quezadaminter/GrblJogCtrlSchematic/ButtonMatrix.sch

## KiCad design ButtonMatrix.sch (2022-01-11)

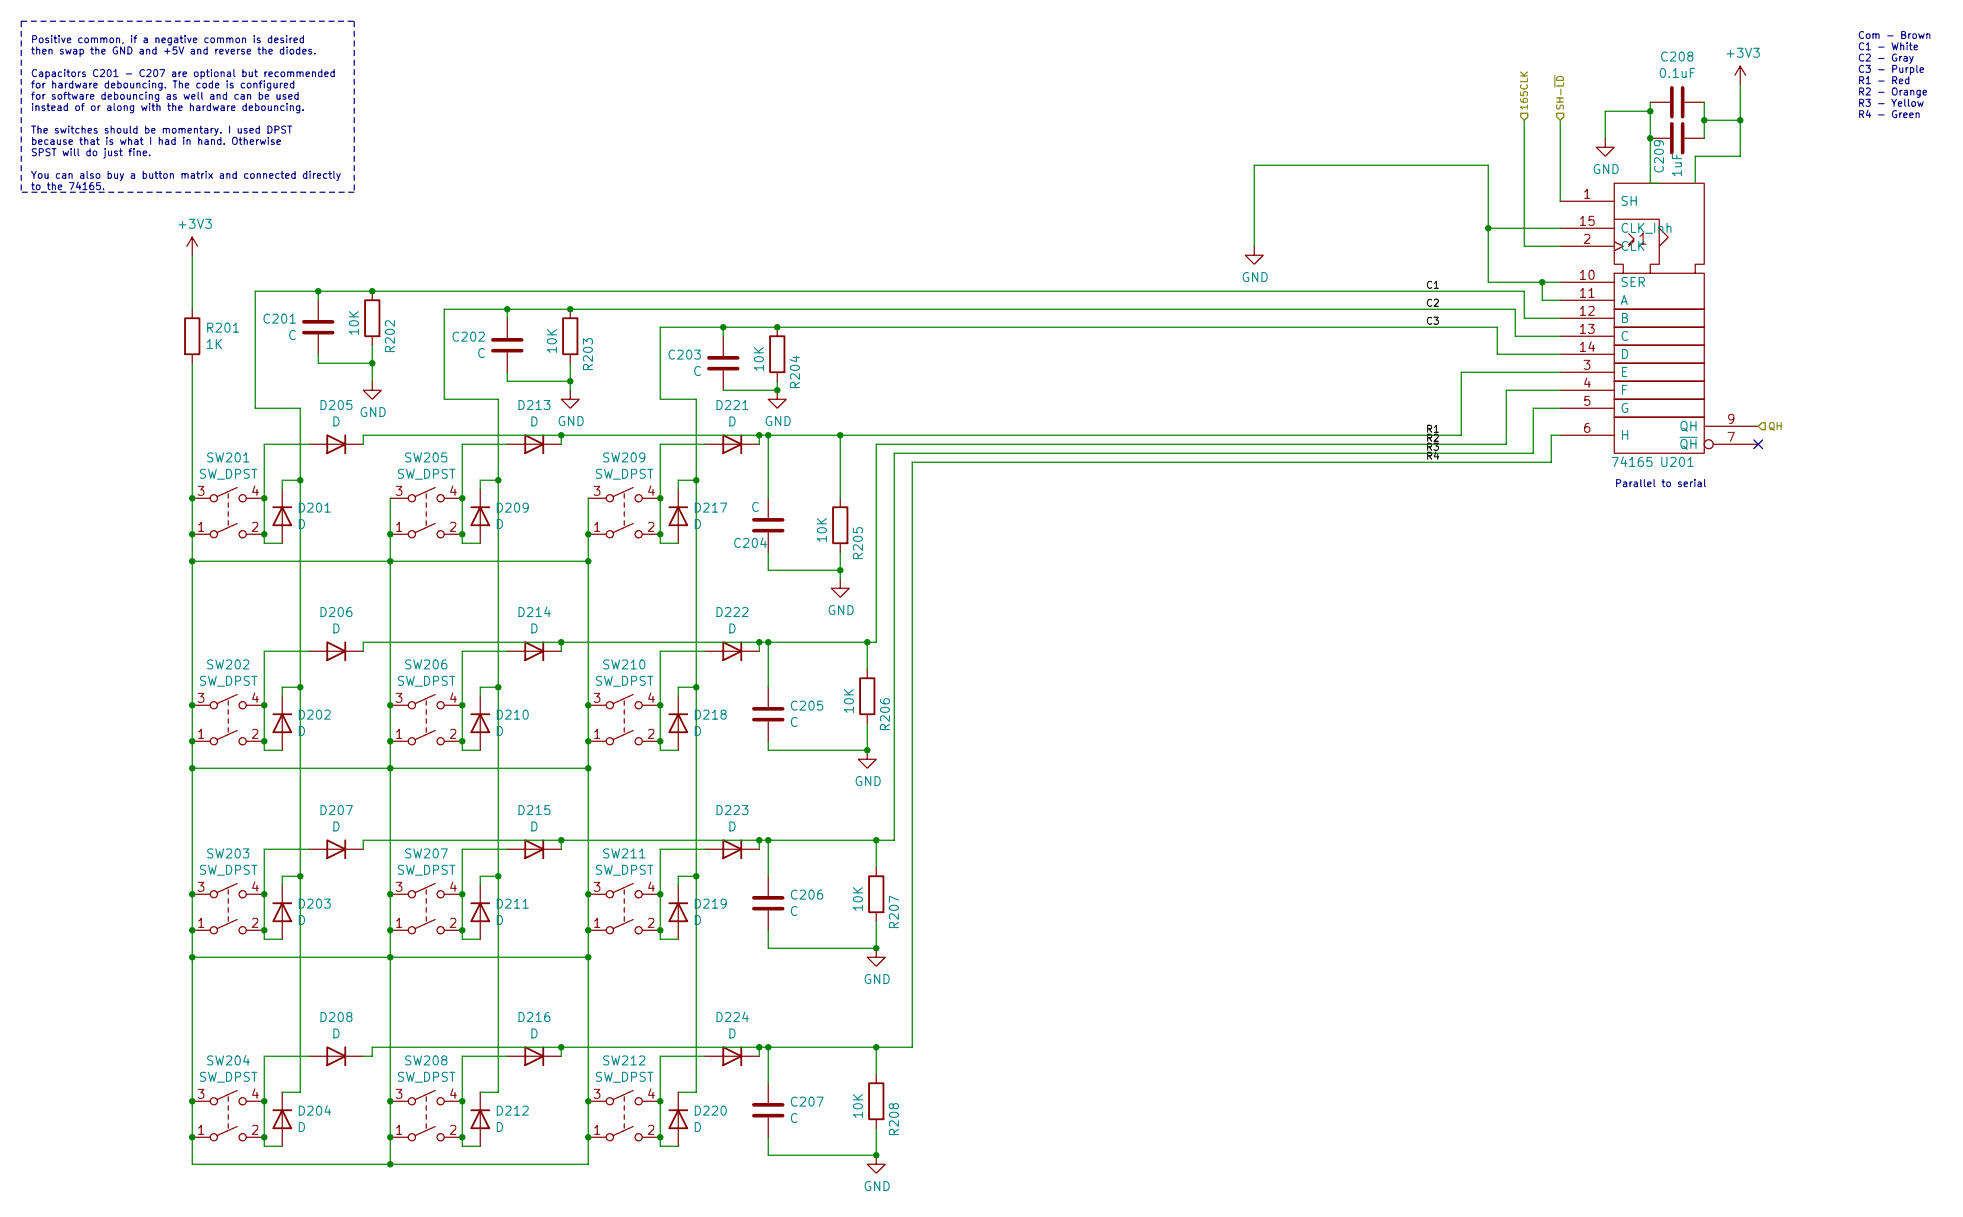
[picture p1: schematic ButtonMatrix.sch]

Parts:
C201, C202, C203, C204, C205, C206, C207: C
C208: 0.1uF
C209: 1uF
D201, D202, D203, D204, D205, D206, D207, D208, D209, D210, D211, D212, D213, D214, D215, D216, D217, D218, D219, D220, D221, D222, D223, D224: D
R201: 1K
R202, R203, R204, R205, R206, R207, R208: 10K
SW201, SW202, SW203, SW204, SW205, SW206, SW207, SW208, SW209, SW210, SW211, SW212: SW_DPST
U201: 74165

Connections:
165CLK: U201.2 (CLK)
+3V3: C208.1, C209.1, R201.1, U201.16 (VCC)
C1: C201.2, D201.1 (K), D202.1 (K), D203.1 (K), D204.1 (K), R202.1, U201.12 (B)
C2: C202.2, D209.1 (K), D210.1 (K), D211.1 (K), D212.1 (K), R203.1, U201.13 (C)
C3: C203.2, D217.1 (K), D218.1 (K), D219.1 (K), D220.1 (K), R204.1, U201.14 (D)
GND: C201.1, C202.1, C203.1, C204.2, C205.2, C206.2, C207.2, C208.2, C209.2, R202.2, R203.2, R204.2, R205.2, R206.2, R207.2, R208.2, U201.8 (GND), U201.10 (SER), U201.11 (A), U201.15 (CLK_Inh)
unnamed: D201.2 (A), D205.2 (A), SW201.2, SW201.4
unnamed: D202.2 (A), D206.2 (A), SW202.2, SW202.4
unnamed: D203.2 (A), D207.2 (A), SW203.2, SW203.4
unnamed: D204.2 (A), D208.2 (A), SW204.2, SW204.4
unnamed: D209.2 (A), D213.2 (A), SW205.2, SW205.4
unnamed: D210.2 (A), D214.2 (A), SW206.2, SW206.4
unnamed: D211.2 (A), D215.2 (A), SW207.2, SW207.4
unnamed: D212.2 (A), D216.2 (A), SW208.2, SW208.4
unnamed: D217.2 (A), D221.2 (A), SW209.2, SW209.4
unnamed: D218.2 (A), D222.2 (A), SW210.2, SW210.4
unnamed: D219.2 (A), D223.2 (A), SW211.2, SW211.4
unnamed: D220.2 (A), D224.2 (A), SW212.2, SW212.4
unnamed: R201.2, SW201.1, SW201.3, SW202.1, SW202.3, SW203.1, SW203.3, SW204.1, SW204.3, SW205.1, SW205.3, SW206.1, SW206.3, SW207.1, SW207.3, SW208.1, SW208.3, SW209.1, SW209.3, SW210.1, SW210.3, SW211.1, SW211.3, SW212.1, SW212.3
QH: U201.9 (QH)
R1: C204.1, D205.1 (K), D213.1 (K), D221.1 (K), R205.1, U201.3 (E)
R2: C205.1, D206.1 (K), D214.1 (K), D222.1 (K), R206.1, U201.4 (F)
R3: C206.1, D207.1 (K), D215.1 (K), D223.1 (K), R207.1, U201.5 (G)
R4: C207.1, D208.1 (K), D216.1 (K), D224.1 (K), R208.1, U201.6 (H)
SH-~LD: U201.1 (SH)

Notes on the sheet:
Com - Brown C1 - White C2 - Gray C3 - Purple R1 - Red R2 - Orange R3 - Yellow R4 - Green
Parallel to serial
Positive common, if a negative common is desired then swap the GND and +5V and reverse the diodes. Capacitors C201 - C207 are optional but recommended for hardware debouncing. The code is configured for software debouncing as well and can be used instead of or along with the hardware debouncing. Th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
