quezadaminter/GrblJogCtrlSchematic/ER-TFT035-6_LCD_Interface.sch

## KiCad design ER-TFT035-6_LCD_Interface.sch (2022-01-11)

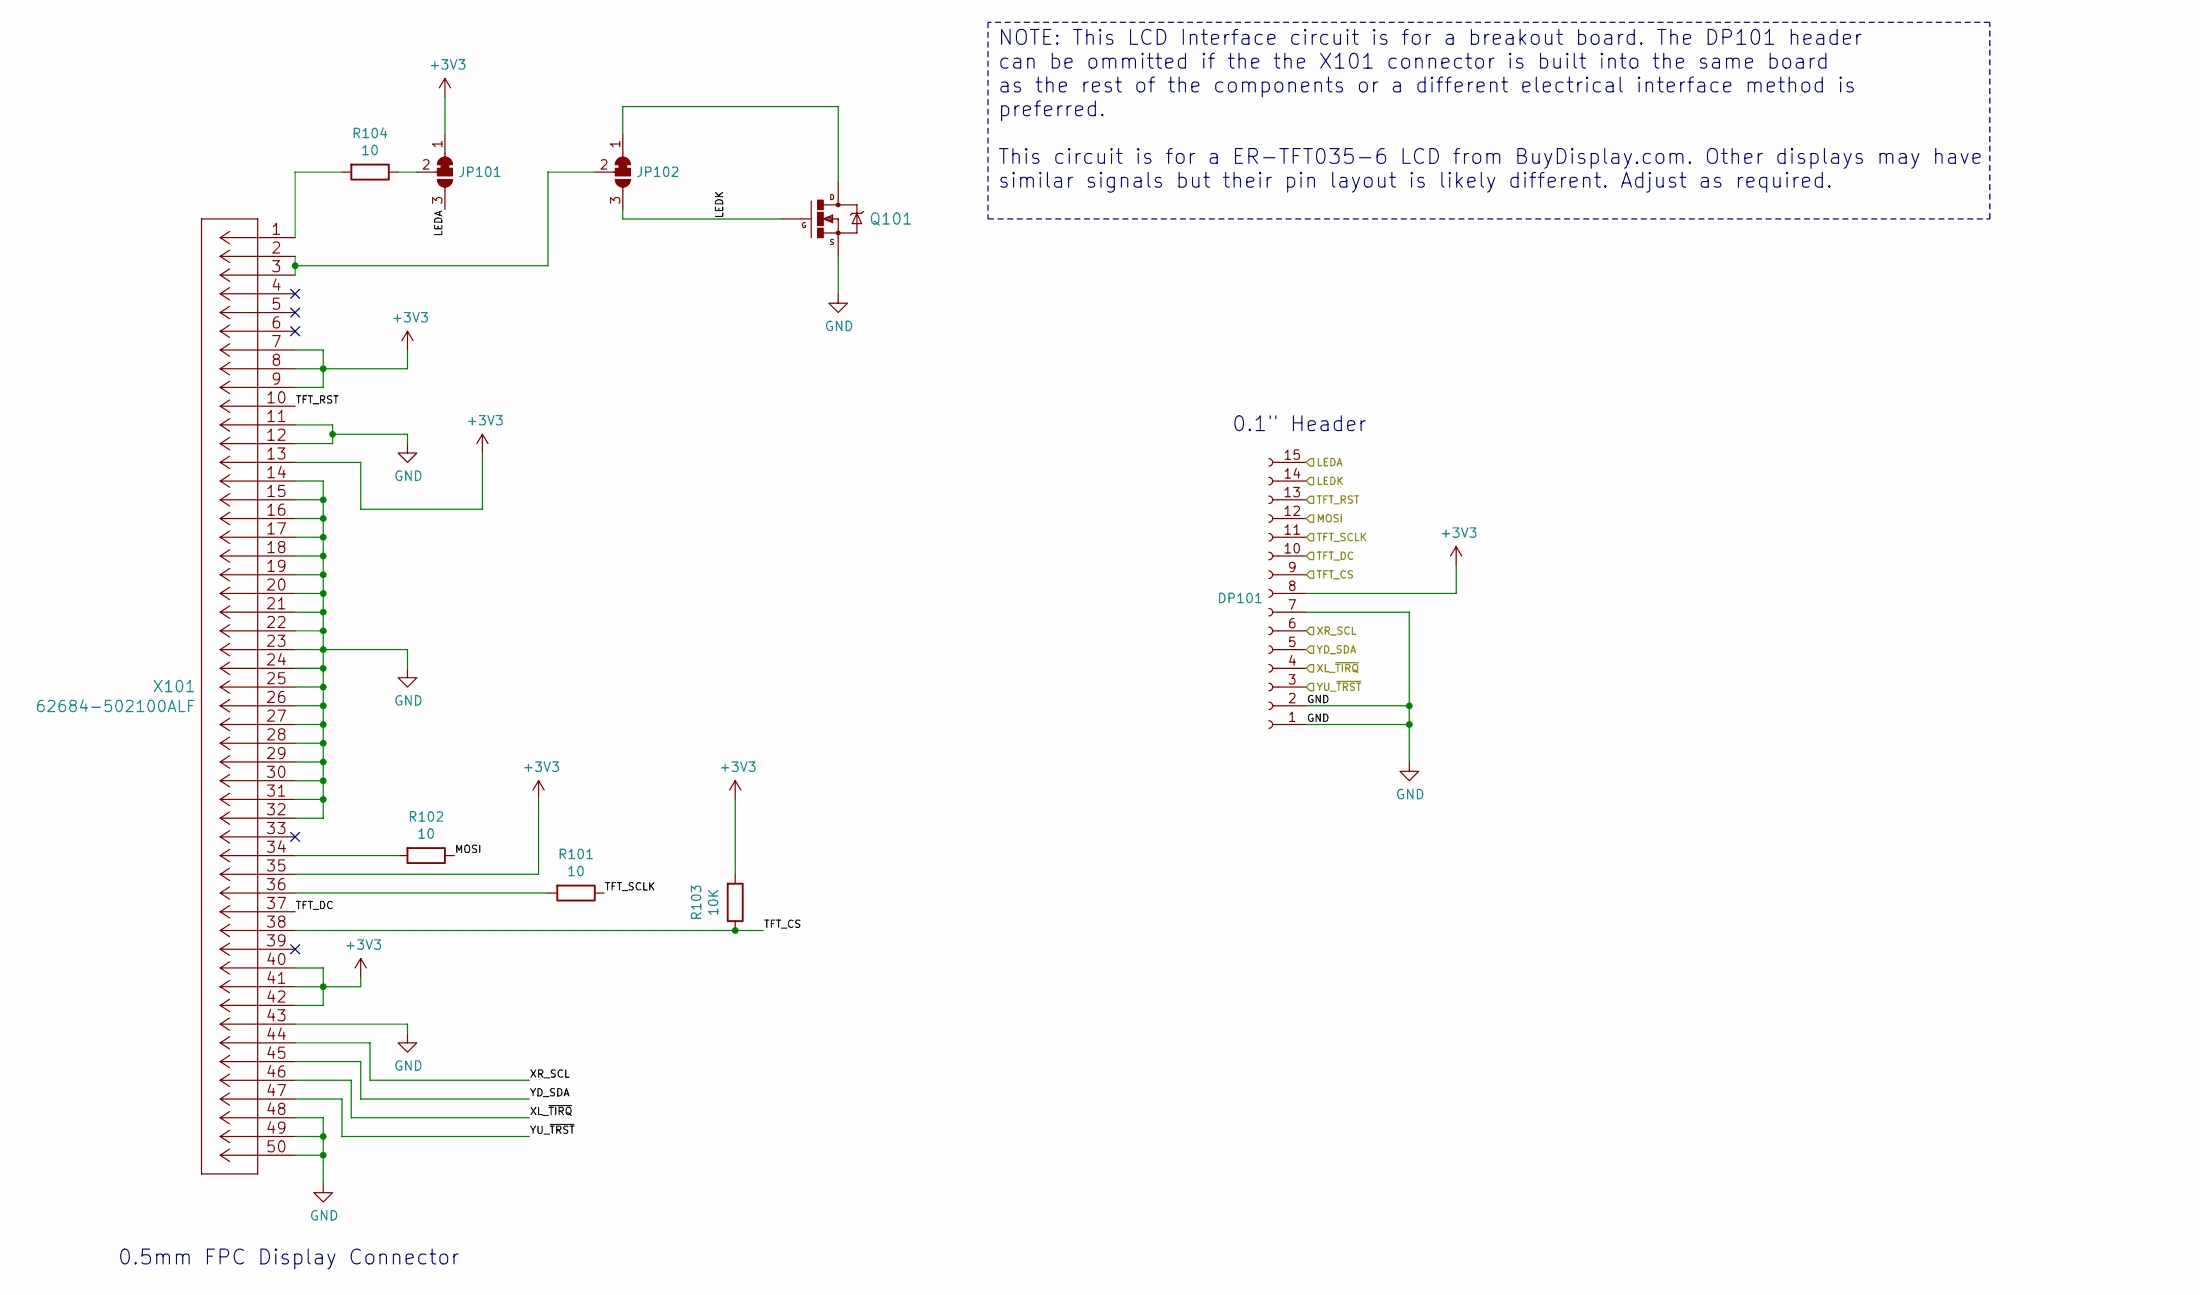
[picture p2: schematic ER-TFT035-6_LCD_Interface.sch]

Parts:
DP101: Conn_01x15_Female; BUY_LCD_TFT035-6_320x480-BO
JP101, JP102: SolderJumper_3_Bridged12
Q101: IRLML0040TR
R101, R102, R104: 10
R103: 10K
X101: 62684-502100ALF; CONN50_62684-502100ALF_FCI

Connections:
+3V3: DP101.8, JP101.1 (A), R103.2, X101.7, X101.8, X101.9, X101.13, X101.35, X101.40, X101.41, X101.42
GND: DP101.1, DP101.2, DP101.7, Q101.2 (S), X101.11, X101.12, X101.14, X101.15, X101.16, X101.17, X101.18, X101.19, X101.20, X101.21, X101.22, X101.23, X101.24, X101.25, X101.26, X101.27, X101.28, X101.29, X101.30, X101.31, X101.32, X101.43, X101.48, X101.49, X101.50
LEDA: DP101.15, JP101.3 (B)
LEDK: DP101.14, JP102.3 (B), Q101.1 (G)
MOSI: DP101.12, R102.1
unnamed: JP101.2 (C), R104.1
unnamed: JP102.1 (A), Q101.3 (D)
unnamed: JP102.2 (C), X101.2, X101.3
unnamed: R101.2, X101.36
unnamed: R102.2, X101.34
unnamed: R104.2, X101.1
TFT_CS: DP101.9, R103.1, X101.38
TFT_DC: DP101.10, X101.37
TFT_RST: DP101.13, X101.10
TFT_SCLK: DP101.11, R101.1
XL_~TIRQ: DP101.4, X101.46
XR_SCL: DP101.6, X101.44
YD_SDA: DP101.5, X101.45
YU_~TRST: DP101.3, X101.47

Notes on the sheet:
NOTE: This LCD Interface circuit is for a breakout board. The DP101 header can be ommitted if the the X101 connector is built into the same board as the rest of the components or a different electrical interface method is preferred. This circuit is for a ER-TFT035-6 LCD from BuyDisplay.com. Other d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
0.1" Header
0.5mm FPC Display Connector
