quezadaminter/GrblJogCtrlSchematic/XCarveDRO.sch

## KiCad design XCarveDRO.sch (2022-01-11)

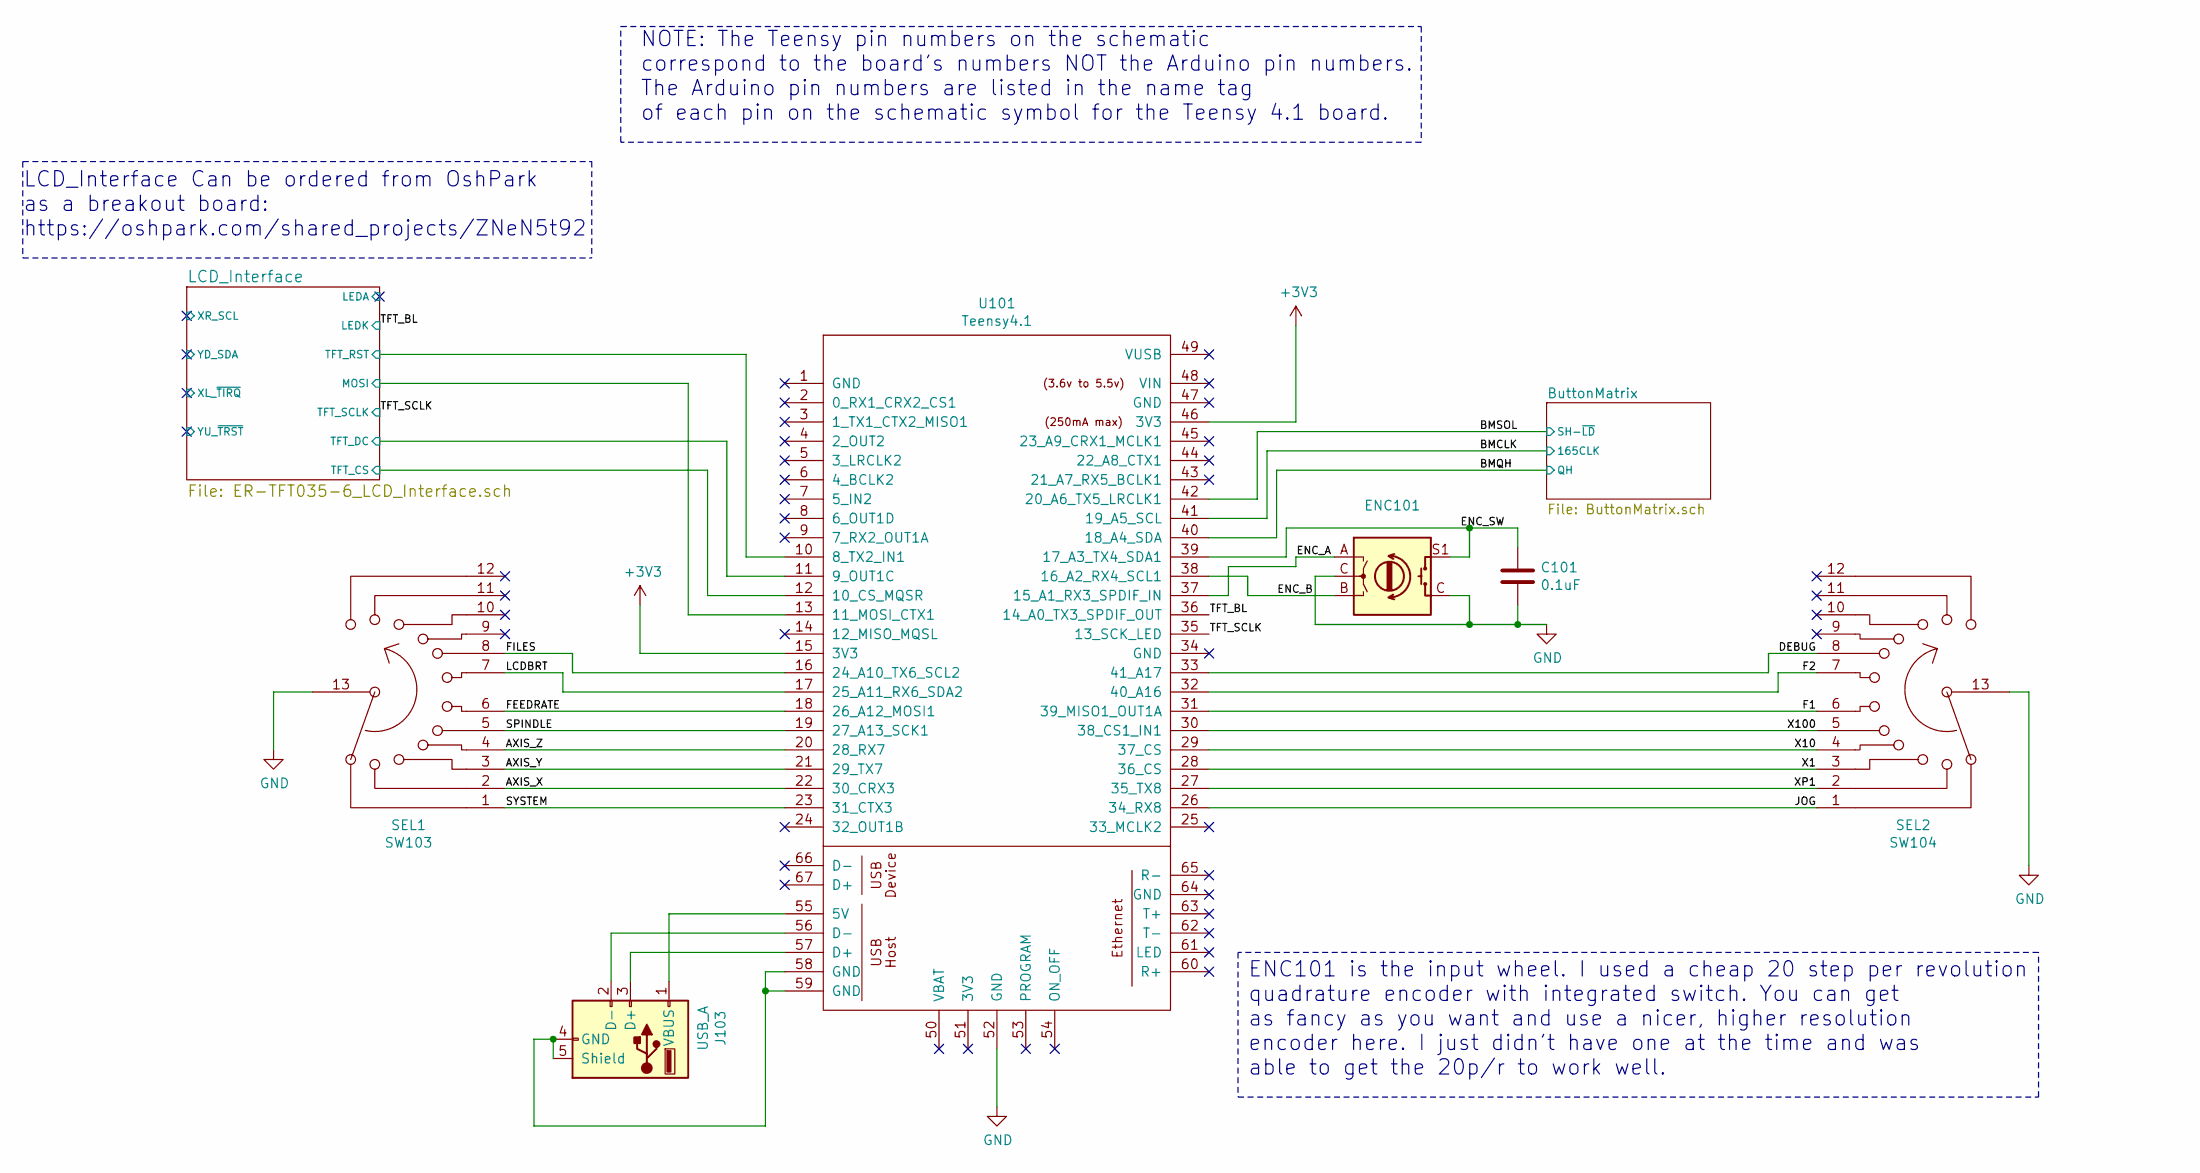
[picture p3: schematic XCarveDRO.sch]

Parts:
C101: 0.1uF
ENC101: Encoder; TSWA3NCD23LFS-NavScroll-Switch; DigiKey PEC11L-4120F-S0020-ND
J103: USB_A; USB_A_Stewart_SS-52100-001_Horizontal
SW103: SEL1; SWITCH_ROTARY_4-12
SW104: SEL2; SWITCH_ROTARY_4-12
U101: Teensy4.1; Teensy41

Connections:
+3V3: U101.15 (3V3), U101.46 (3V3)
AXIS_X: SW103.2, U101.22 (30_CRX3)
AXIS_Y: SW103.3, U101.21 (29_TX7)
AXIS_Z: SW103.4, U101.20 (28_RX7)
BMCLK: U101.41 (19_A5_SCL)
BMQH: U101.40 (18_A4_SDA)
BMSOL: U101.42 (20_A6_TX5_LRCLK1)
DEBUG: SW104.8, U101.33 (41_A17)
ENC_A: ENC101.A, U101.37 (15_A1_RX3_SPDIF_IN)
ENC_B: ENC101.B, U101.38 (16_A2_RX4_SCL1)
ENC_SW: C101.1, ENC101.S1, U101.39 (17_A3_TX4_SDA1)
F1: SW104.6, U101.31 (39_MISO1_OUT1A)
F2: SW104.7, U101.32 (40_A16)
FEEDRATE: SW103.6, U101.18 (26_A12_MOSI1)
FILES: SW103.8, U101.16 (24_A10_TX6_SCL2)
GND: C101.2, ENC101.C, SW103.13, SW104.13, U101.52 (GND)
JOG: SW104.1, U101.26 (34_RX8)
LCDBRT: SW103.7, U101.17 (25_A11_RX6_SDA2)
MOSI: U101.13 (11_MOSI_CTX1)
unnamed: J103.1 (VBUS), U101.55 (5V)
unnamed: J103.2 (D-), U101.56 (D-)
unnamed: J103.3 (D+), U101.57 (D+)
unnamed: J103.4 (GND), J103.5 (Shield), U101.58 (GND), U101.59 (GND)
SPINDLE: SW103.5, U101.19 (27_A13_SCK1)
SYSTEM: SW103.1, U101.23 (31_CTX3)
TFT_BL: U101.36 (14_A0_TX3_SPDIF_OUT)
TFT_CS: U101.12 (10_CS_MQSR)
TFT_DC: U101.11 (9_OUT1C)
TFT_RST: U101.10 (8_TX2_IN1)
TFT_SCLK: U101.35 (13_SCK_LED)
X1: SW104.3, U101.28 (36_CS)
X10: SW104.4, U101.29 (37_CS)
X100: SW104.5, U101.30 (38_CS1_IN1)
XP1: SW104.2, U101.27 (35_TX8)

Notes on the sheet:
NOTE: The Teensy pin numbers on the schematic correspond to the board's numbers NOT the Arduino pin numbers. The Arduino pin numbers are listed in the name tag of each pin on the schematic symbol for the Teensy 4.1 board.
ENC101 is the input wheel. I used a cheap 20 step per revolution quadrature encoder with integrated switch. You can get as fancy as you want and use a nicer, higher resolution encoder here. I just didn't have one at the time and was able to get the 20p/r to work well.
LCD_Interface Can be ordered from OshPark as a breakout board: https://oshpark.com/shared_projects/ZNeN5t92
