quezadaminter/GrblJogCtrlSchematic/(threads)

Thread 2 (2021-12-29):

R201 value query

wile1411, 2021-12-29:
Is R201 in the button matrix supposed to be 1K and not 10k?
I ask as setting it to 10k would make the pin float when the button is pushed wouldn't it?

wile1411, 2021-12-29:
I'm having a crack at replicating this as it seemed a great project for the holidays. Teensy implementations worked well.
I've make my own button board. Wiring up the selectors after this.

wile1411, 2021-12-29:
By the way, thanks so much for a fantastically documented project. The man-in-the-middle is a great solution while keeping all the flexibility and I'm very much enjoying building this.

quezadaminter, 2021-12-31:
Hi @wile1411,
I'm glad you are finding this project worth your time :). I am out of town and I cannot check the board first hand. I'll see if I can find some other pictures on my phone that may provide a clue on the value of the R201. If I can't find it right away I'll report back as soon as I get back home. I'll also take a look again at the schematics to see if I can work it out from there. Good luck!

quezadaminter, 2021-12-31:
Just looking at the schematic, I think you are right. It definitely makes sense to make R201 a 1K resistor instead of 10K. I will double check the hardware when I get home but it does make sense. I'll amend the schematic once I get a chance. Thank you for catching this!

quezadaminter, 2022-01-05:
I updated the schematic to show the change on R201 from 10K to 1K. Thank you for picking this out!

Closed 2022-01-05.

Thread 3 (2022-01-19):

Has this been tested yet?

GeorgeIoak, 2022-01-19:
Thanks for sharing your design. I'm looking at a similar project that will use this 3.5" LCD panel from Buy Display and I wanted to know if you've built this and confirmed that the display breakout board worked.

quezadaminter, 2022-01-19:
This schematic is part of a project. I am not sure when you ask if it has been tested, which part of the project you are referring to. This is what the screen looks like where I am using the schematic in this repository:

https://github.com/quezadaminter/GrblJogCtrl/blob/master/1.gif

GeorgeIoak, 2022-01-19:
Sorry, I was referring to the LCD board uploaded to OSH Park? Is that version built and working? Looks like it is but I wasn't sure if the design files posted here matched what was shown in the video

quezadaminter, 2022-01-19:
Got it. The oshpark board does work, it has been tested. You are also correct that it is not the same as the one in the videos which is an earlier version. The current version moves some of the hardware onto the board so you don't have to do what I did to the one on the video and hack the components onto it.

Good luck with your project, happy to answer any other questions. If you find this one answered please remember to close the issue :).

GeorgeIoak, 2022-01-19:
Perfect, just wanted to make sure since sometimes repos and hardware can be out of sink and I was trying to not make the "same mistake"!

Closed 2022-01-19.
