quezadaminter/GrblJogCtrlSchematic/(commit log)

2021-01-10 Initial commit with schematic only.
    [ButtonMatrix.sch, Display.sch, XCarveDRO.sch]
2021-01-10 Create SVG files of the schematic so folks don't have to use KiCAD to view it.
2021-01-10 Add SVG of schematics.
2022-01-05 Use new link for TFT breakout board on OshPark.
2022-01-05 Based on feedback, update silkscreen on DP101 and link to OSHPark, R201 from 10K to 1K.
    [ButtonMatrix.sch, XCarveDRO.sch]
2022-01-11 Update schematic to use the oshpark board layout so there is more consistency between the two. Update notes descriptions and bump to revision 1.
    [ButtonMatrix.sch, ER-TFT035-6_LCD_Interface.sch, XCarveDRO.sch]
