quezadaminter/GrblJogCtrlSchematic/(notices)

Notices in the files:
Display.sch:
CC BY-SA
